farmerkeith/SolarChargerSZBK07ModuleV2/schematic_18/SZBK07_18.pdf

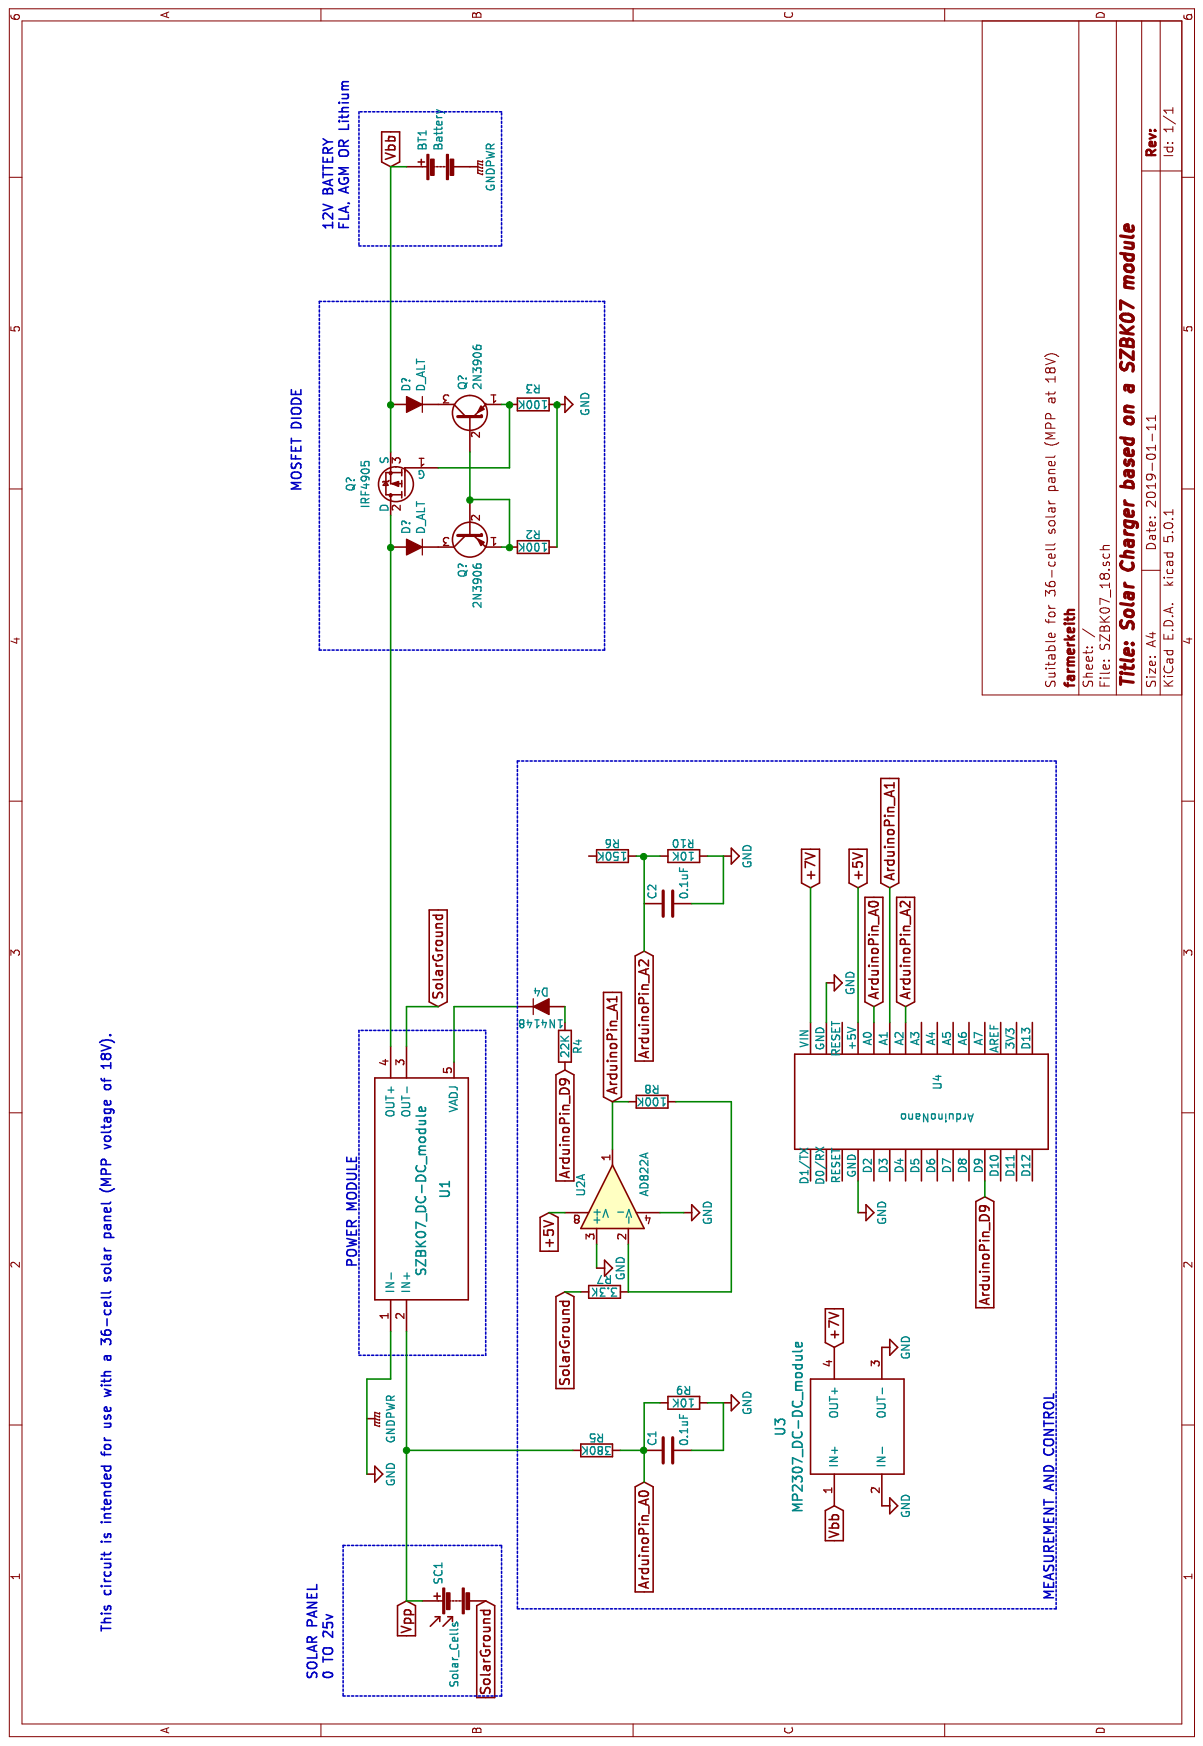
[picture p1: page 1]
