farmerkeith/SolarChargerSZBK07ModuleV2/documents/Project diary.ods

13-Jul-18 | After Debasish emailed me about Hackaday Energy Harvesing competition, I decided to try and submit an entry.
 | Entry is MPPT charger based on SZBK07, MOSFET diode, Op-amp current sensor using the 4 milli Ohm resistor in the SZBK01.
 | Software will be a library with a MPPT class. Configurable for battery set points; temperature input; interface to get logging data out.
 | Hardware schematic just about done.
14-Jul-18 | Calculation of voltage divider and current shunt ratios
 |  | HiV or HiA | Vref | Rlo | Rhi |  | Full scale | Code | Multiplier | Scale factor | FS result
 | Solar | 40 | 1 | 10 | 390 | Divider | 1023 | 40000 | 39.1006842619746 | 40000 | 40920 | scale_factor = (Rhi+Rlo)*1000/Rlo
 | Battery | 16 | 1 | 10 | 150 | Divider | 1023 | 16000 | 15.6402737047898 | 16000 | 16368 | scale_factor = (Rhi+Rlo)*1000/Rlo
 | Current | 8 | 1 | 3.3 | 100 | Op-amp | 1023 | 8000 | 7.82013685239492 | 8.06451612903226 | 8250 | scale+factor = 1000*Rlo/Rhi/Rs/1023
 |  |  | sense R | 0.004 | sense V | 0.032 | amplified | 0.96969696969697 | code= | 992 | 8000
 |  | Current = Vmeas * Rlo/Rhi/Rs |  |  | 8
 |  | HiV or HiA | Vref | Rlo | Rhi |  | Multiplier | Full scale
 | Solar | 40 | 1 | 10 | 390 | Divider | 39.1006842619746 | 40000
 | Battery | 16 | 1 | 10 | 150 | Divider | 15.6402737047898 | 16000
 | Current | 8 | 1 | 3.3 | 100 | Op-amp | 8.06451612903226 | 8250
 |  | sense R | 0.004
 | Multiplier for current = 1000*Rlo/Rhi/Rs/1023
 | Multiplier for voltage = 1000*(Rhi + Rlo)/Rlo/1023
15-Jul-18 | Working on software – initial version now complete and started testing / debugging
 | Set up breadboard with Arduino, voltage dividers and current shunt amplifier, and connected with the SZBK01.
 | Using a schottky diode instead of the MOSFET diode at this stage to reduce build time.
16-Jul-18 | Working on software – initial version now complete and started testing / debugging.
 | Solved various calibration problems with the voltage and current measurements.
 | PWM control of the DC converter appears to work well.
