farmerkeith/SolarChargerSZBK07ModuleV2/(commit log)

2018-07-16 BOM added
    [SZBK07V2BOM.csv]
2018-07-17 corrected MOSFET to PSMN3R3-80PS
    [SZBK07.sch]
2018-07-28 updated MOSFET diode circuit
    [SZBK07.sch]
2019-01-06 R1 added, error in original
    [SZBK07-2018-10-10-19-48-09.sch, SZBK07.sch]
2019-01-06 R1 added, error fixed
    [SZBK07.sch]
2019-01-11 revised with 2 versions for 18V and 30V panels
    [SZBK07-2018-10-10-19-48-09.sch, SZBK07.kicad_pcb, SZBK07.sch, SZBK07V2BOM.csv, SZBK07_18.kicad_pcb, SZBK07_18.sch]
